Setok24/CircuitSax-Recreation/kicad/digsax1.kicad_pcb

## KiCad design kicad/digsax1.kicad_pcb (2025-08-01)

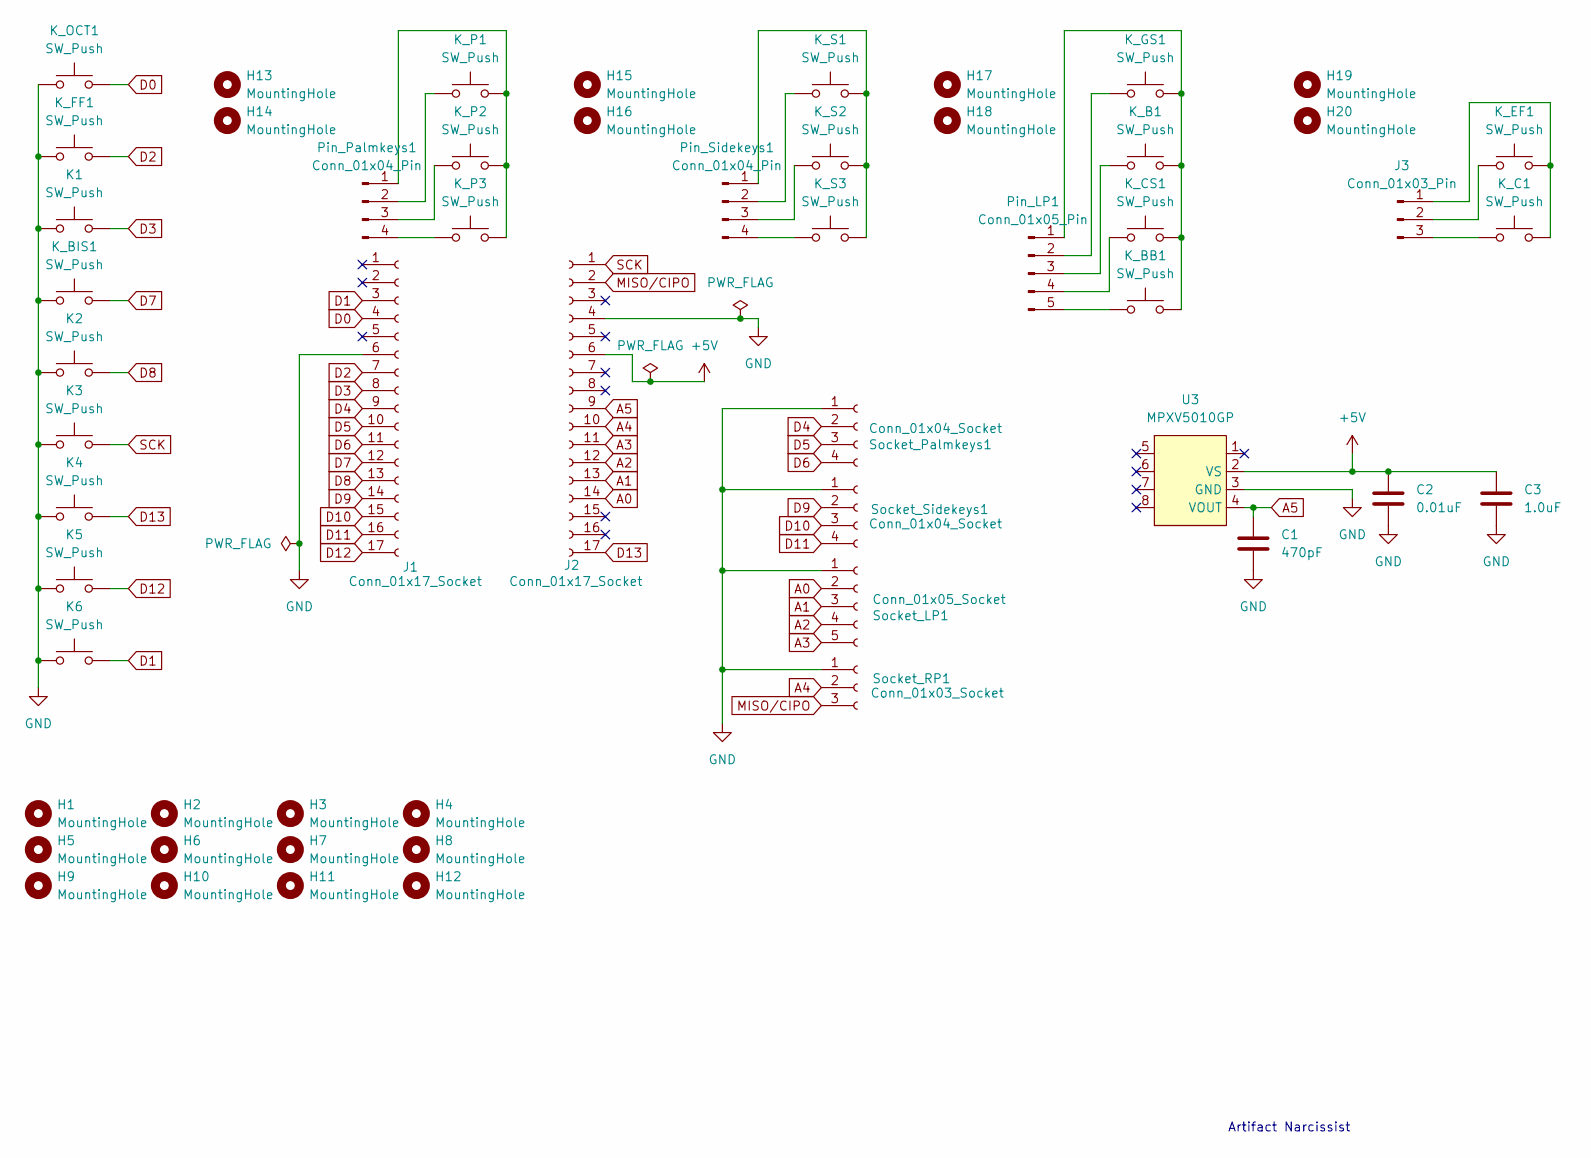
[picture p12: schematic digsax1.kicad_sch]

Parts:
C1: 470pF; C_0805_2012Metric
C2: 0.01uF; C_0805_2012Metric
C3: 1.0uF; C_0805_2012Metric
H1, H2, H3, H4, H5, H6, H7, H8, H9, H10, H11, H12, H13, H14, H15, H16, H17, H18, H19, H20: MountingHole; MountingHole_3.2mm_M3
J1, J2: Conn_01x17_Socket; PinSocket_1x17_P2.54mm_Vertical
J3: Conn_01x03_Pin; PinHeader_1x03_P2.54mm_Vertical
K1, K2, K3, K4, K5, K6: SW_Push; SW_Cherry_MX_1.00u_PCB
K_B1: SW_Push; SW_Cherry_MX_1.00u_PCB
K_BB1: SW_Push; SW_Cherry_MX_1.00u_PCB
K_BIS1: SW_Push; SW_Cherry_MX_1.00u_PCB
K_C1: SW_Push; SW_Cherry_MX_1.00u_PCB
K_CS1: SW_Push; SW_Cherry_MX_1.00u_PCB
K_EF1: SW_Push; SW_Cherry_MX_1.00u_PCB
K_FF1: SW_Push; SW_Cherry_MX_1.00u_PCB
K_GS1: SW_Push; SW_Cherry_MX_1.00u_PCB
K_OCT1: SW_Push; SW_Cherry_MX_1.00u_PCB
K_P1, K_P2, K_P3: SW_Push; SW_Cherry_MX_1.00u_PCB
K_S1, K_S2, K_S3: SW_Push; SW_Cherry_MX_1.00u_PCB
Pin_LP1: Conn_01x05_Pin; PinHeader_1x05_P2.54mm_Vertical
Pin_Palmkeys1: Conn_01x04_Pin; PinHeader_1x04_P2.54mm_Vertical
Pin_Sidekeys1: Conn_01x04_Pin; PinHeader_1x04_P2.54mm_Vertical
Socket_LP1: Conn_01x05_Socket; PinSocket_1x05_P2.54mm_Vertical
Socket_Palmkeys1: Conn_01x04_Socket; PinSocket_1x04_P2.54mm_Vertical
Socket_RP1: Conn_01x03_Socket; PinSocket_1x03_P2.54mm_Vertical
Socket_Sidekeys1: Conn_01x04_Socket; PinSocket_1x04_P2.54mm_Vertical
U3: MPXV5010GP; DIP-6_W7.62mm_LongPads

Connections:
+5V: C2.1, C3.1, J2.6, U3.2 (VS)
A0: J2.14, Socket_LP1.2
A1: J2.13, Socket_LP1.3
A2: J2.12, Socket_LP1.4
A3: J2.11, Socket_LP1.5
A4: J2.10, Socket_RP1.2
A5: C1.1, J2.9, U3.4 (VOUT)
D0: J1.4, K_OCT1.2
D1: J1.3, K6.2
D2: J1.7, K_FF1.2
D3: J1.8, K1.2
D4: J1.9, Socket_Palmkeys1.2
D5: J1.10, Socket_Palmkeys1.3
D6: J1.11, Socket_Palmkeys1.4
D7: J1.12, K_BIS1.2
D8: J1.13, K2.2
D9: J1.14, Socket_Sidekeys1.2
D10: J1.15, Socket_Sidekeys1.3
D11: J1.16, Socket_Sidekeys1.4
D12: J1.17, K5.2
D13: J2.17, K4.2
GND: C1.2, C2.2, C3.2, J1.6, J2.4, K1.1, K2.1, K3.1, K4.1, K5.1, K6.1, K_BIS1.1, K_FF1.1, K_OCT1.1, Socket_LP1.1, Socket_Palmkeys1.1, Socket_RP1.1, Socket_Sidekeys1.1, U3.3 (GND)
unnamed: J3.1, K_C1.2, K_EF1.2
unnamed: J3.2, K_EF1.1
unnamed: J3.3, K_C1.1
unnamed: K_B1.2, K_BB1.2, K_CS1.2, K_GS1.2, Pin_LP1.1
unnamed: K_GS1.1, Pin_LP1.2
unnamed: K_B1.1, Pin_LP1.3
unnamed: K_CS1.1, Pin_LP1.4
unnamed: K_BB1.1, Pin_LP1.5
unnamed: K_P1.2, K_P2.2, K_P3.2, Pin_Palmkeys1.1
unnamed: K_P1.1, Pin_Palmkeys1.2
unnamed: K_P2.1, Pin_Palmkeys1.3
unnamed: K_P3.1, Pin_Palmkeys1.4
unnamed: K_S1.2, K_S2.2, K_S3.2, Pin_Sidekeys1.1
unnamed: K_S1.1, Pin_Sidekeys1.2
unnamed: K_S2.1, Pin_Sidekeys1.3
unnamed: K_S3.1, Pin_Sidekeys1.4
SCK: J2.1, K3.2

Notes on the sheet:
Artifact Narcissist

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
Board: 2 copper layers, 55 parts (1 on the bottom side), 40 nets, no tracks yet.
